FAB-VINE/fab-vine-prototype/LANDING-PAGE/README.md

# Fab Vine Landing Page

This folder contains the public Fab Vine landing page.

Development:

```bash
npm install
npm run dev
```

Production build:

```bash
npm run build
```
