FAB-VINE/fab-vine-prototype/PROJECT-INFO/README.md

# Fab Vine Prototype
[][cc-by-nc]

Repository for the Fab Vine prototype, including ideas, design files, source code, manuals, and public-facing web material. This is a project under development.

## Repository Structure

- [MANUALS/](../MANUALS) - contributor and assembly documentation.
- [BUILD-FILES/](../BUILD-FILES) - fabrication files, PCB designs, and wiring diagrams.
- [NODE-LOGIC/](../NODE-LOGIC) - firmware and shared code for physical nodes.
- [BRAIN-SERVER/](../BRAIN-SERVER) - server and data processing.
- [LANDING-PAGE/](../LANDING-PAGE) - public Fab Vine website.
- [SIMULATION/](../SIMULATION) - virtual installation and fake data tools.
- [LAUNCH-TOOLS/](../LAUNCH-TOOLS) - scripts for flashing, testing, and updates.

## Public Landing

The public Fab Vine landing page lives in [LANDING-PAGE/](../LANDING-PAGE).

## License

This work is licensed under [Creative Commons Attribution-NonCommercial 4.0 International License][cc-by-nc]

[][cc-by-nc]

[cc-by-nc]: https://creativecommons.org/licenses/by-nc/4.0/
[cc-by-nc-image]: https://licensebuttons.net/l/by-nc/4.0/88x31.png
[cc-by-nc-shield]: https://img.shields.io/badge/License-CC%20BY--NC%204.0-lightgrey.svg
