FAB-VINE/fab-vine-prototype/BUILD-FILES/3d-designs/fab-vine-node-sprint5/README.md

# Fab Vine Node Sprint 5 3D Design Files

Status: Sprint 5 workspace
Purpose: placeholder for the next physical design iteration

This folder is reserved for the new sprint's 3D modeling, fabrication exports, and design previews.

## Suggested Structure

- `rhino/` - Rhino source models.
- `grasshopper/` - Grasshopper definitions.
- `exports/` - fabrication-ready exports such as STL, STEP, DXF, or laser/CNC files.
- `media/` - photos, render previews, and progress videos.

## Notes

- Keep large source files in Git LFS when needed.
- Keep progress media in `media/` so the web manual can reference it directly.
- Add short notes here whenever the geometry or fabrication direction changes.
