FAB-VINE/fab-vine-prototype/BUILD-FILES/pcb-designs/fab-vine-node-sprint5/README.md

# Fab Vine Node Sprint 5 PCB Design Files

Status: Sprint 5 workspace
Purpose: placeholder for the next electronics and board iteration

This folder is reserved for Sprint 5 PCB notes, schematics, fabrication files, pinout references, and board previews.

## Suggested Structure

- `schematics/` - schematic images or PDFs.
- `previews/` - board layout and 3D render images.
- `gerbers/` - fabrication packages.
- `reference/` - pin maps, connector notes, datasheets, or spreadsheets.
- `3d-model/` - board 3D exports.

## Starting Point

Sprint 5 should treat the Sprint 4/V3 behavior as a reference, but use this folder for any new board decisions so previous sprint documentation stays stable.
