FAB-VINE/fab-vine-prototype/MANUALS/design-rules.md

# Design Rules

How to design a snap-part for Fab Vine.

This guide will define geometry constraints, connector logic, module scale, material assumptions, and naming rules for shared fabrication files.
