FAB-VINE/fab-vine-prototype/BUILD-FILES/pcb-designs/fab-vine-node-sprint3/previews/pcb-3d-bottom.jpeg

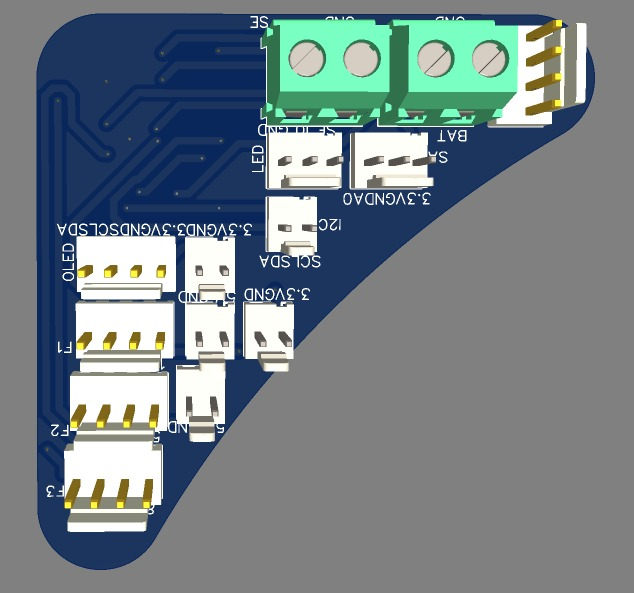
BUILD-FILES/pcb-designs/fab-vine-node-sprint3/previews/pcb-3d-bottom.jpeg
