FAB-VINE/fab-vine-prototype/BUILD-FILES/pcb-designs/fab-vine-node-sprint3/previews/pcb-layout-bottom.jpeg

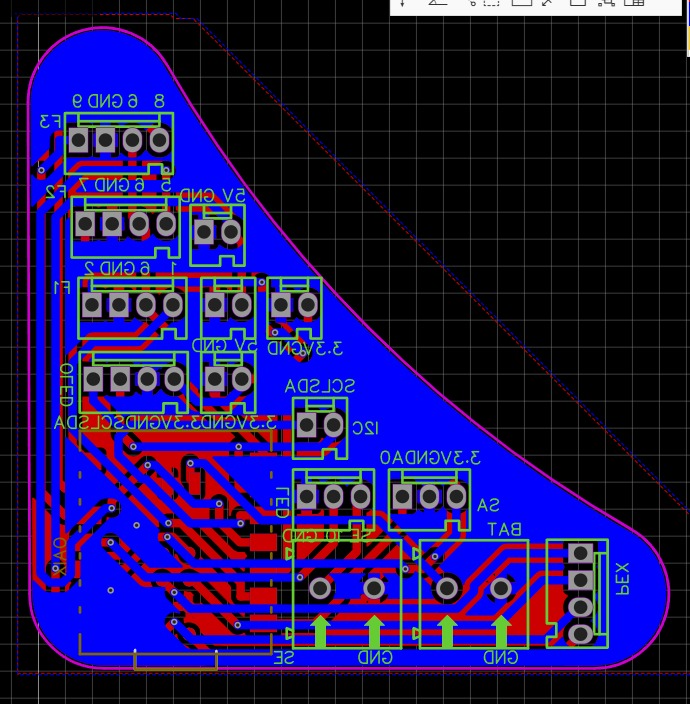
BUILD-FILES/pcb-designs/fab-vine-node-sprint3/previews/pcb-layout-bottom.jpeg
