FAB-VINE/fab-vine-prototype/BUILD-FILES/pcb-designs/fab-vine-node-sprint3/schematics/fab-vine-pcb-sprint3-schematic.jpeg

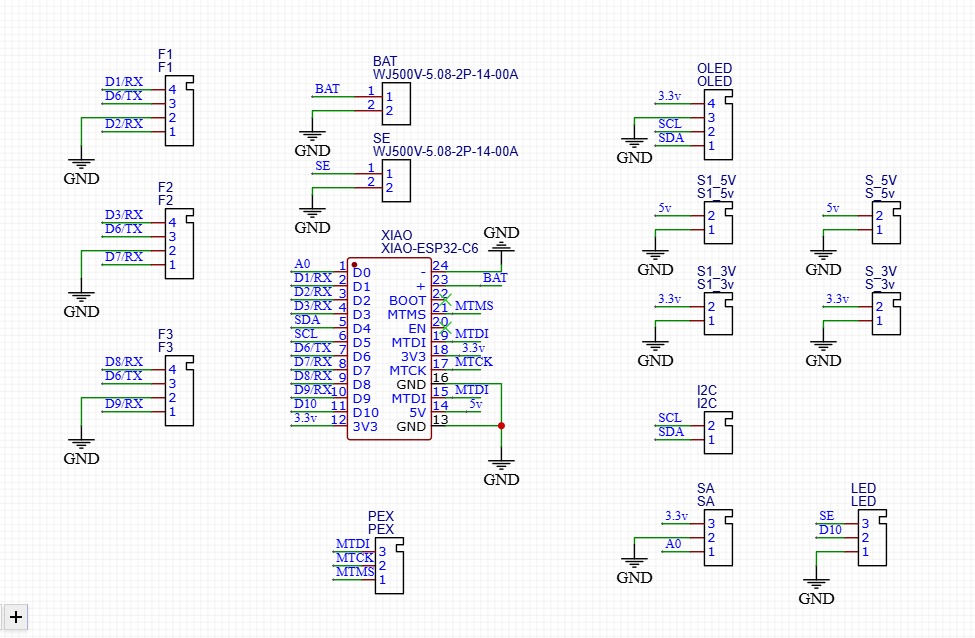
BUILD-FILES/pcb-designs/fab-vine-node-sprint3/schematics/fab-vine-pcb-sprint3-schematic.jpeg
