FAB-VINE/fab-vine-prototype/BUILD-FILES/bom/fab-vine-module-v1-bom.xlsx

Sheet: BOM V1
Categoria | Componente | Cantidad por modulo | Cantidad total 60 modulos | Opcion recomendada | Precio bajo | Precio alto | Total bajo | Total alto | Enlace | Estado | Notas
Microcontrolador | Seeed Studio XIAO ESP32-C6 | 1 | 60 | XIAO ESP32-C6 | $5.00 | $7.00 | $300.00 | $420.00 | https://www.seeedstudio.com/Seeed-Studio-XIAO-ESP32C6-p-5884.html | Decidido | Cerebro del modulo.
Audio | Microfono digital I2S | 1 | 60 | INMP441 I2S MEMS | $1.50 | $4.00 | $90.00 | $240.00 | https://www.amazon.com/-/es/micr%C3%B3fono-omnidireccional-INMP441-compatible-precisi%C3%B3n/dp/B0C1C64R8S/ | Decidido | Usualmente viene en pack.
Pantalla | OLED 128x64 I2C | 1 | 60 | SSD1306 0.96 in | $2.50 | $4.00 | $150.00 | $240.00 | https://www.amazon.com/-/es/gp/product/B09T6SJBV5 | Decidido | I2C, compatible con firmware actual.
Iluminacion | Tira LED direccionable | 1 | 60 | WS2812B / NeoPixel 5V, 4 tiras de 10 LEDs | $4.00 | $8.00 | $240.00 | $480.00 | https://www.amazon.com/-/es/gp/product/B0CYGZWWXJ | Decidido | 40 LEDs por modulo; elegir variante 5V.
Alimentacion / senal | Micro-Fit 3.0 pre-armado | 2 | 120 | 4-pin pigtail / cable assembly | $2.00 | $6.00 | $240.00 | $720.00 | https://www.digikey.com/en/product-highlight/m/molex/micro-fit-3-0-pre-crimped-jumper-leads | Decidido | Para 5V, GND, DATA y extra.
Conexion modular | Conector pogo magnetico 3 pines | 4 | 240 | 3Pin magnetic pogo | $0.50 | $2.00 | $120.00 | $480.00 | https://www.amazon.com/-/es/gp/product/B0D93X2TTT | Opcional | Solo senal/docking; no corriente LED principal.
Alimentacion general | Fuente 5V DC | 0.05 | 3 | Mean Well LRS-350-5, 5V 60A | $30.00 | $45.00 | $90.00 | $135.00 | https://www.digikey.com/en/products/detail/mean-well-usa-inc/LRS-350-5/7705037 | Decidido | Tres fuentes total, una por cada 20 modulos.
Estructura | Carcasa / soporte | 1 | 60 | 3D print / laser cut | $12.00 | $12.00 | $720.00 | $720.00 | Pendiente | Decidido | Estimado por modulo.
Resumen |  |  |  |  | Bajo | Alto
Total BOM para 60 modulos |  |  |  |  | $1950.00 | $3435.00
Total por modulo equivalente |  |  |  |  | $32.50 | $57.25
Total fuentes compartidas |  |  |  |  | $90.00 | $135.00
Total estructura 60 modulos |  |  |  |  | $720.00 | $720.00
Notas | Los precios son rangos de planificacion. Confirmar antes de compra.

Sheet: Power Plan
Power Plan
Modulos | 60 | Rama | Modulos
LEDs por modulo | 40 | A | 20
Total LEDs | 2400 | B | 20
Consumo max LED (A) | 0.1 | C | 20
Consumo max LEDs (A) | 144.0 | Total | 60
Electronica por modulo (A) | 0.3
Consumo electronica (A) | 18.0
Total max estimado (A) | 162.0
Fuentes recomendadas | 3 x Mean Well LRS-350-5, 5V 60A
Architecture note
Use thick 5V/GND distribution wiring for LED power. Micro-Fit style connectors can carry module power and signal. Magnetic pogo connectors should stay optional for signal, docking, detect lines, or alignment.
Do not pass main LED current through generic pogo pins.
