FAB-VINE/fab-vine-prototype/BUILD-FILES/pcb-designs/fab-vine-node-sprint3/reference/fab-vine-xiao-esp32c6-pinout-sprint3.xlsx

Fab Vine - XIAO ESP32-C6 Pinout Sprint 3
D6 is the common social TX. Each face has one RX pin. PCB faces should cross TX to RX and connect GND to GND.
Pin / Pad XIAO | GPIO real | Capacidades oficiales | Función en Fab Vine | Uso Sprint 3 | Estado | Notas PCB
D0 | GPIO0 | Digital, Analog A0, LP_GPIO0 | Expansión futura; pin lateral libre para sensor/configuración | Libre / reservado | Libre | Dejar test pad o header opcional; no conectar a caras en Sprint 3.
D1 | GPIO1 | Digital, Analog A1, LP_GPIO1 | Escuchar vecino en cara 2 | FACE_2_RX | Usado | Entrada RX de cara; recibir TX_COMMON del vecino. Pull-down recomendado.
D2 | GPIO2 | Digital, Analog A2, LP_GPIO2 | Escuchar vecino en cara 3 | FACE_3_RX | Usado | Entrada RX de cara; recibir TX_COMMON del vecino. Pull-down recomendado.
D3 | GPIO21 | Digital, SDIO_DATA1 | Escuchar vecino en cara 4 | FACE_4_RX | Usado | Entrada RX de cara; recibir TX_COMMON del vecino. Pull-down recomendado.
D4 | GPIO22 | Digital, I2C SDA, SDIO_DATA2 | Datos de pantalla OLED | OLED_SDA | Usado | Ruta I2C a OLED SSD1306; mantener corta y con pull-ups si el módulo OLED no los incluye.
D5 | GPIO23 | Digital, I2C SCL, SDIO_DATA3 | Reloj de pantalla OLED | OLED_SCL | Usado | Ruta I2C a OLED SSD1306; mantener junto a SDA.
D6 | GPIO16 | Digital, UART TX | Transmitir presencia social común a todas las caras | NEIGHBOR_TX_COMMON | Usado | Distribuir a los pads TX de las 6 caras. Opcional 220R serie desde D6 antes de ramificar.
D7 | GPIO17 | Digital, UART RX | Escuchar vecino en cara 6 | FACE_6_RX | Usado | Entrada RX de cara; recibir TX_COMMON del vecino. Pull-down recomendado.
D8 | GPIO19 | Digital, SPI SCK, SDIO_CLK | Escuchar vecino en cara 5 | FACE_5_RX | Usado | Entrada RX de cara; recibir TX_COMMON del vecino. Pull-down recomendado.
D9 | GPIO20 | Digital, SPI MISO, SDIO_DATA0 | Escuchar vecino en cara 1 | FACE_1_RX | Usado | Entrada RX de cara; recibir TX_COMMON del vecino. Pull-down recomendado.
D10 | GPIO18 | Digital, SPI MOSI, SDIO_CMD | Controlar tira LED WS2812B / NeoPixel | LED_DATA | Usado | Salida hacia DIN de LEDs. Recomendado 220R-470R serie cerca del XIAO.
3V3 | Power | 3.3V logic rail | Alimentar OLED y referencias lógicas | 3V3_LOGIC | Usado | No usar para alimentar tira LED. Puede alimentar pull-ups/pull-downs de señal.
5V / VBUS | Power | 5V desde USB o entrada 5V | Alimentación principal o rail para LEDs, según diseño | 5V_POWER | Usar con cuidado | No llevar potencia principal por pogo de caras. Dimensionar según consumo de LEDs.
GND | Power | Tierra común | Tierra de todo el módulo y conectores de caras | GND | Usado | Plano común. Cada cara debe tener GND y conectar GND-GND con el vecino.
EN | Control | Enable / reset del chip | Reset del microcontrolador | RESET_ENABLE | Reservado | No usar como IO normal. Puede ir a test pad/botón reset.
BOOT | Control / GPIO9 | Boot / programming mode | Programación y recuperación | BOOT_MODE | Reservado | Evitar como IO de módulo; mantener accesible para programación.
BAT+ | Power | Entrada batería positiva | Batería futura | BATTERY_POSITIVE | Reservado | Solo si el diseño incluye batería/carga. No usar para señal.
BAT- | Power | Entrada batería negativa | Batería futura | BATTERY_NEGATIVE | Reservado | Conectar según arquitectura de batería; normalmente referencia a GND.
Back pad GPIO4 / A4 | GPIO4 | Analog A4, LP_GPIO4, LP_UART_RXD | Expansión futura desde pad posterior | Libre | Libre | Pad posterior útil para sensor o configuración futura si se decide soldar al reverso.
Back pad GPIO5 / A5 | GPIO5 | Analog A5, LP_GPIO5, LP_UART_TXD | Expansión futura desde pad posterior | Libre | Libre | Pad posterior útil para sensor o configuración futura si se decide soldar al reverso.
Back pad GPIO6 / A6 | GPIO6 | Analog A6, LP_GPIO6, LP_I2C_SDA | Expansión futura desde pad posterior | Libre | Libre | Pad posterior; evitar si complica ensamble. Puede ser I2C alterno futuro.
Back pad GPIO7 | GPIO7 | LP_GPIO7, LP_I2C_SCL, MTDO | Expansión futura desde pad posterior | Libre | Libre | Pad posterior; también aparece asociado a JTAG MTDO. Usar solo si se decide liberar debug.
MTDI | Debug | JTAG debug | Expansión futura / test pad de desarrollo | Libre | Libre | Mantener accesible como test pad si hay espacio.
MTDO | Debug | JTAG debug | Expansión futura / test pad de desarrollo | Libre | Libre | Mantener accesible como test pad si hay espacio.
MTCK | Debug | JTAG debug | Expansión futura / test pad de desarrollo | Libre | Libre | Mantener accesible como test pad si hay espacio.
MTMS | Debug | JTAG debug | Expansión futura / test pad de desarrollo | Libre | Libre | Mantener accesible como test pad si hay espacio.
Face connector summary
Cara | RX único | TX común | GND | Conexión esperada entre módulos
Cara 1 | D9 | D6 | GND | TX de un módulo toca RX del otro; GND toca GND.
Cara 2 | D1 | D6 | GND | TX de un módulo toca RX del otro; GND toca GND.
Cara 3 | D2 | D6 | GND | TX de un módulo toca RX del otro; GND toca GND.
Cara 4 | D3 | D6 | GND | TX de un módulo toca RX del otro; GND toca GND.
Cara 5 | D8 | D6 | GND | TX de un módulo toca RX del otro; GND toca GND.
Cara 6 | D7 | D6 | GND | TX de un módulo toca RX del otro; GND toca GND.
