FAB-VINE/fab-vine-prototype/BUILD-FILES/pcb-designs/fab-vine-node-sprint3/3d-model/OBJ_PCB_FabVine.obj

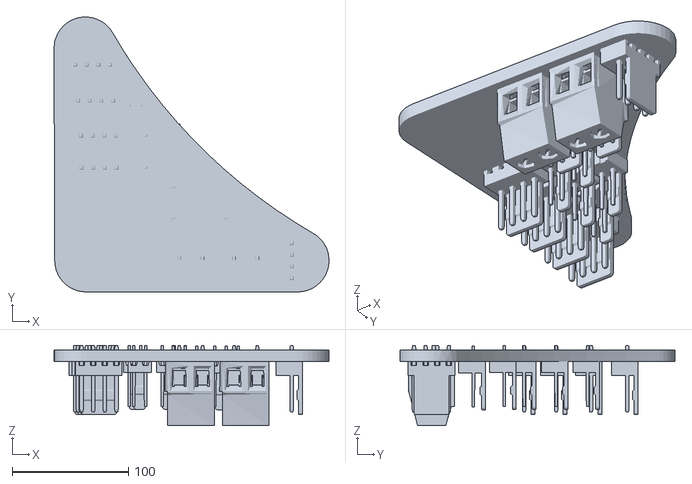
[picture p9: CAD file, 2026-06-02]
BUILD-FILES/pcb-designs/fab-vine-node-sprint3/3d-model/OBJ_PCB_FabVine.obj
236.1 x 236.1 x 68.9
