FAB-VINE/fab-vine-prototype/(list of files, cad)

Other CAD files:
BUILD-FILES/3d-designs/fab-vine-node-sprint4/rhino/updated_units_june_1V2.3dm
