FAB-VINE/fab-vine-prototype/BUILD-FILES/wiring-diagrams/face-wires.md

# How to fabricate the face wires

This documents shows how to build the 3 wirings that include the embedded plugs for each face and connects this with the 3 molex in the PCB for face detection and columniation.

Thus each face needs 3 wires: shared TX (where this node broadcasts), face RX (where it receives the neighbor broadcast), and GND to ensure a reliable serial communication.

### Tools required

| Tool | Details |
|---|---|
| Soldering Iron | Any that can be used to solder wires |
| Solder Wire | |
| Termal Swink wire insulator | Required to seal the cable unions |
| Wire cutter | |
| Wire stripper | |

## Type Red Wire (Top-Right faces)

1 Cut and strip thw wires: 
- 4 pin molex with 10cm of wire
- 3 pin female no wire
- 3 pin male molex with 19.5cm of wire (yellow 1cm shorter)

2.1 Connect long wires coming form the same side (V shape): 
- 4pin yellow to 3pin long (19.5cm) yellow
- 4pin red to 3pin long (19.5cm) black
- 4pin white to 3pin long(19.5cm) red

2.2 solder the 2.1 step wires

3.1 Add insulators to the wires

3.2 Solder GND y TX to female molex:
- 4pin black to female molex first (1) pin (See img for pin number reference;)
- 4pin red (GND) to female molex second (2) pin
- 4pin white to female molex third (3) pin

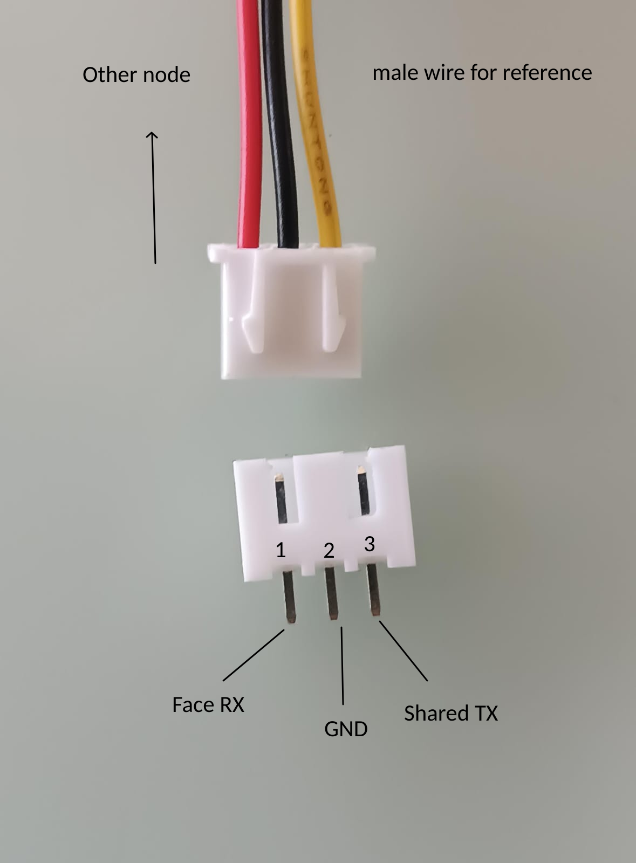
[picture p14: BUILD-FILES/wiring-diagrams/img/female-header-pin-reference.png]
Female header pin reference


You should end with a cable like this: 

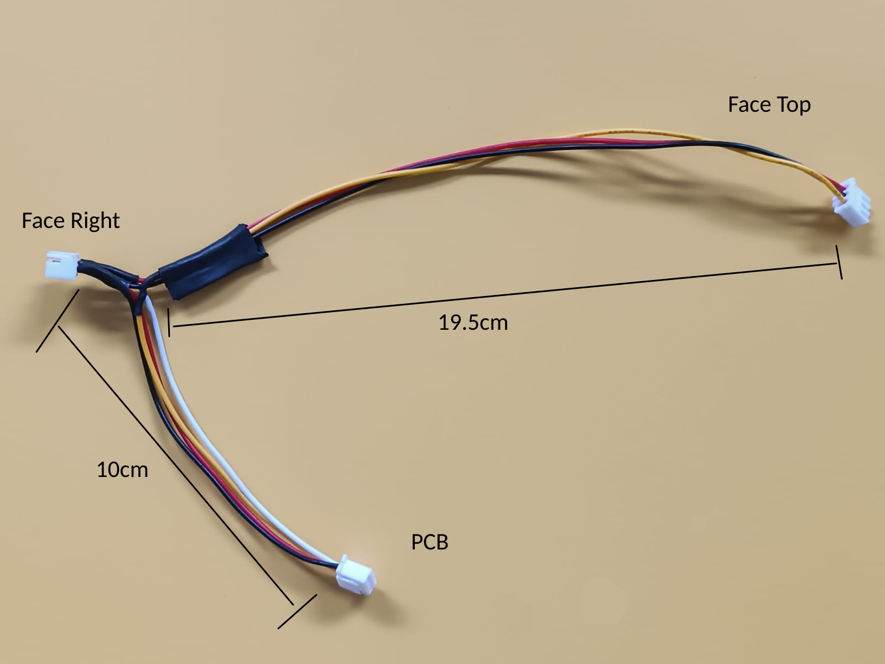
[picture p15: BUILD-FILES/wiring-diagrams/img/final-type-red-cable.png]
Detail of type red wire with dimensions


## Type Green Wire (Left-Front faces)

1 Cut and strip wires: 
- 4pin male molex with 9.5cm of wire
- 3pin male molex with 4.5cm of wire
- 3pin male molex with 12cm of wire

2.1 Connect long wires coming form the same side (V shape): 
- 4pin yellow to 3pin long (12cm) yellow
- 4pin red to 3pin long (12cm) black
- 4pin white to 3pin long(12cm) red

2.2 solder the 2.1 step wires

3.1 Add insulators to the wires

3.2 Connect short wires from the opposite side (Y shape):
- 4pin black to 3pin short (4.5cm) yellow
- 4pin red to 3pin short (4.5cm) black
- 4pin white to 3pin short (4.5cm) red

3.3 Solder and seal the insulators

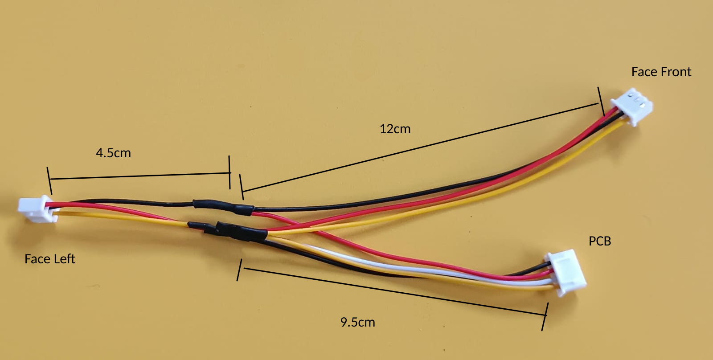
[picture p16: BUILD-FILES/wiring-diagrams/img/final-type-green-cable.png]
Detail and measure of the left front face wire


## Type Blue Wire (Bottom-Posterior faces)

1 Cut and strip wires: 
- 4pin male molex with 6cm of wire
- 3pin female molex with 4.5cm of wire (yellow 1cm shorter)
- 3pin female molex

1.1 Solder 3pin female molex to 4.5cm wires:
- yellow wire to female molex first (1) pin
- black wire to female molex second (2) pin
- red wire to female molex third (3) pin

Please check img for reference:
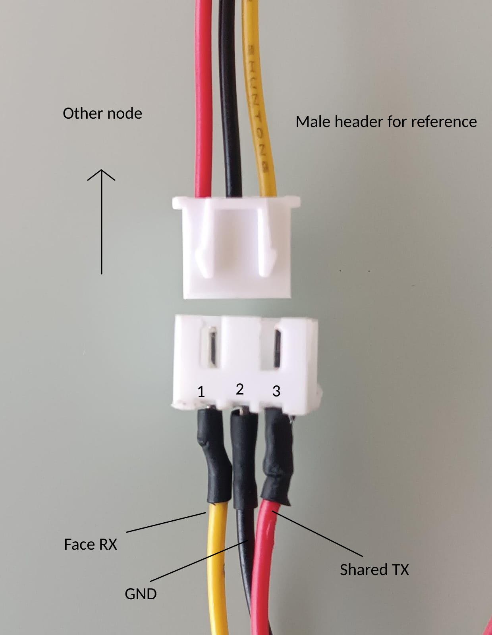
[picture p17: BUILD-FILES/wiring-diagrams/img/female-header-wire-reference.png]
Female wire reference


1.2 Place insulators on the female molex with wires

2.1 Connect wires coming form the same side (V shape):
- 4pin black to 3pin short (4.5cm) yellow
- 4pin red to 3pin short (4.5cm) black
- 4pin white to 3pin short (4.5cm) red

2.2 solder the 2.1 step wires

3.1 Add insulators to the wires

3.2 Solder GND y TX to female molex:
- 4pin black to female molex first (1) pin
- 4pin red (GND) to female molex second (2) pin
- 4pin white to female molex third (3) pin

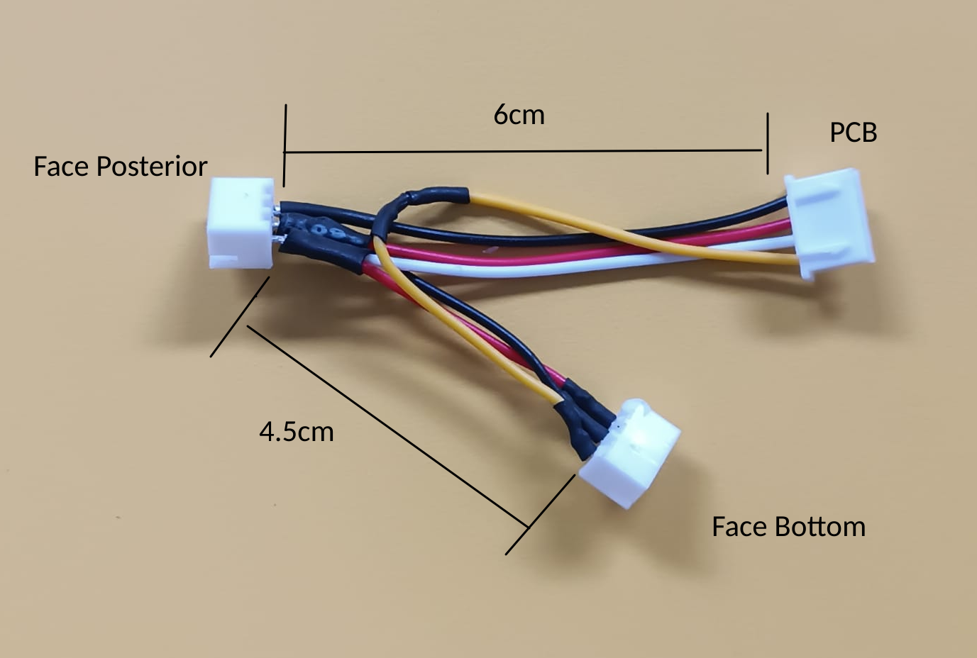
[picture p18: BUILD-FILES/wiring-diagrams/img/final-type-blue-cable.png]
Detail and measures of the right posterior face wire
