FAB-VINE/fab-vine-prototype/MANUALS/index.md

# Fab Vine Manuals

This folder is the home for build, assembly, and contribution manuals.

Main HTML manual browser:

- [Manual index](index.html)
- [Getting started](getting-started.html)
- [Design rules](design-rules.html)
- [Node Sprint 5 workspace and LED program guide](node-sprint5.html)
- [Node Sprint 4 integration](node-sprint4-integration.html)
- [Node PCB Sprint 3](node-pcb-sprint3.html)
- [OLED expressions manual](oled-expressions.html)

General entry points:

- [Physical node](physical-node.html)
- [Node V1](node-v1.html)
- [Brain server](brain-server.html)
- [Simulation](simulation.html)
- [Launch tools](launch-tools.html)
- [Community](community.html)
- [Assembly guides](assembly-guides/index.html)

Documentation structure:

- Start with the general project area.
- Move into the specific manual.
- Keep technical Markdown near the folder it describes.
- Link browsable HTML manuals from `MANUALS/index.html`.
