FAB-VINE/fab-vine-prototype/MANUALS/assembly-guides/index.html

Fab Vine Manuals

Physical Build

# Assembly guides will document the build step by step.

This section will hold photo-based and technician-friendly instructions for building Fab Vine node parts, mounts, electronics, and final assemblies.

## Coming Next

Add one HTML page per assembly process, then link each guide from this page.

Grow the network.
