FAB-VINE/fab-vine-prototype/MANUALS/getting-started.md

# Getting Started

How to build your first Fab Vine node.

This manual will collect the first complete build path for a contributor: parts, tools, fabrication files, electronics, firmware, and testing.
