FAB-VINE/fab-vine-prototype/(commit log)

2026-05-21 Add Fab Vine landing page
2026-05-21 Align landing with MIT presentation
2026-05-21 Match landing palette to MIT methodology slide
2026-05-21 Fix primary button contrast
2026-05-22 Move landing page to root folder
2026-05-27 Deploy manuals with landing page
2026-05-27 Add manuals link to landing
2026-05-28 Add Fab Vine Module V1 BOM
    [fab-vine-module-v1-bom.xlsx]
2026-05-28 Publish BOM files with GitHub Pages
2026-05-28 Add node wiring and program manual
2026-05-30 Document XIAO pinout and leader wiring
    [XIAO_ESP32C6_Pinout.xlsx]
2026-05-30 Include v1 firmware to prototype communication
2026-05-30 Add documentation for the communications prototype
2026-06-02 Add Sprint 3 PCB fabrication package
    [XIAO_ESP32C6_Pinout.xlsx, fab-vine-xiao-esp32c6-pinout-sprint3.xlsx]
2026-06-02 Add Sprint 3 PCB 3D model
    [OBJ_PCB_FabVine.obj]
2026-06-09 Add Sprint 3 PCB schematic to manual
2026-06-09 Add XIAO pinout to Sprint 3 PCB manual
2026-06-24 Add sprint 4 quick access buttons
2026-06-25 Add sprint 4 3D design package
    [updated_units_june_1V2.3dm]
2026-07-03 docs: wiring documentation for left front faces
2026-07-05 docs: add sprint 5 LED programs and calibration guide
2026-07-07 docs: add second wire details
2026-07-07 docs: update wire instructions
2026-07-07 docs: Add PCB instructions
2026-07-08 feat: add pin solder test script
2026-07-10 feat: add pcb testing scripts
2026-07-15 Add V5 frimware
    Create V5 .ino project
    update faces to match mirror
    Separate Eye Drawing Code
    Fix grammar
    Refactor face detection
    Refactor count faces
    Add point color
    Ignore .vscode folder
    [Color.h, Faces.h, NeighborDetection.cpp, NeighborDetection.h, NodeEyes.cpp, NodeEyes.h, NodeLights.cpp, NodeLights.h]
