FAB-VINE/fab-vine-prototype/(notices)

Notices in the files:
README.md:
CC BY-NC 4.0
